N0R4K-bit/miata-na-popup-controller/docs/screenshots/instagram-demo.png

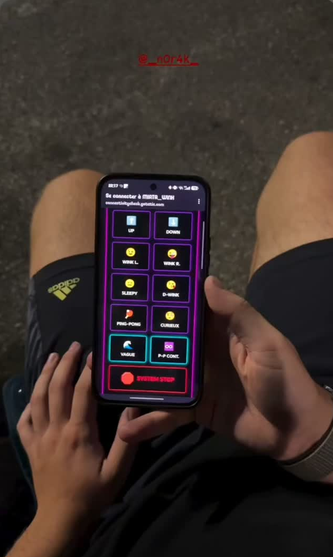
docs/screenshots/instagram-demo.png
