N0R4K-bit/miata-na-popup-controller/Crédits.md

Le câblage de la partie automobile est inspiré du tutoriel [Popup headlight wink with Arduino and relay board](https://www.instructables.com/Popup-headlight-wink-with-arduino-and-relay-board-/) publié sur Instructables. Consultez les conditions d’utilisation et la licence indiquées par l’auteur original avant de reproduire ou redistribuer ses illustrations.
