N0R4K-bit/miata-na-popup-controller/CHANGELOG.md

# Changelog

Toutes les modifications importantes du projet sont documentées dans ce fichier.

Le format suit les principes de Keep a Changelog.

## [Unreleased]

### Prévu

- optimisation des écritures I²C ;
- endpoint de statut JSON ;
- interverrouillage logiciel des directions ;
- interface entièrement autonome sans ressource Internet ;
- amélioration de la cohérence des hauteurs estimées.

## [1.0.0] - 2025-XX-XX

### Ajouté

- point d'accès Wi-Fi `MIATA_WINK` ;
- portail captif ;
- interface web synthwave ;
- commande Up et Down ;
- clin d'œil gauche et droit ;
- animation Sleepy ;
- double clin d'œil ;
- animation Ping-Pong ;
- animation Curieux ;
- vague simple et continue ;
- arrêt logiciel des relais ;
- réglage individuel gauche/droite ;
- bouton physique multifonction ;
- pilotage des relais par PCF8574 ;
- documentation de l'arrêt d'urgence matériel.

### Retiré

- prise en charge des bandeaux WS2812B ;
- relais d'alimentation des éclairages d'ambiance.
